hotchk155/latchbox-lite/hardware/latchbox-lite.brd

## EAGLE design hardware/latchbox-lite.brd (2019-11-06)

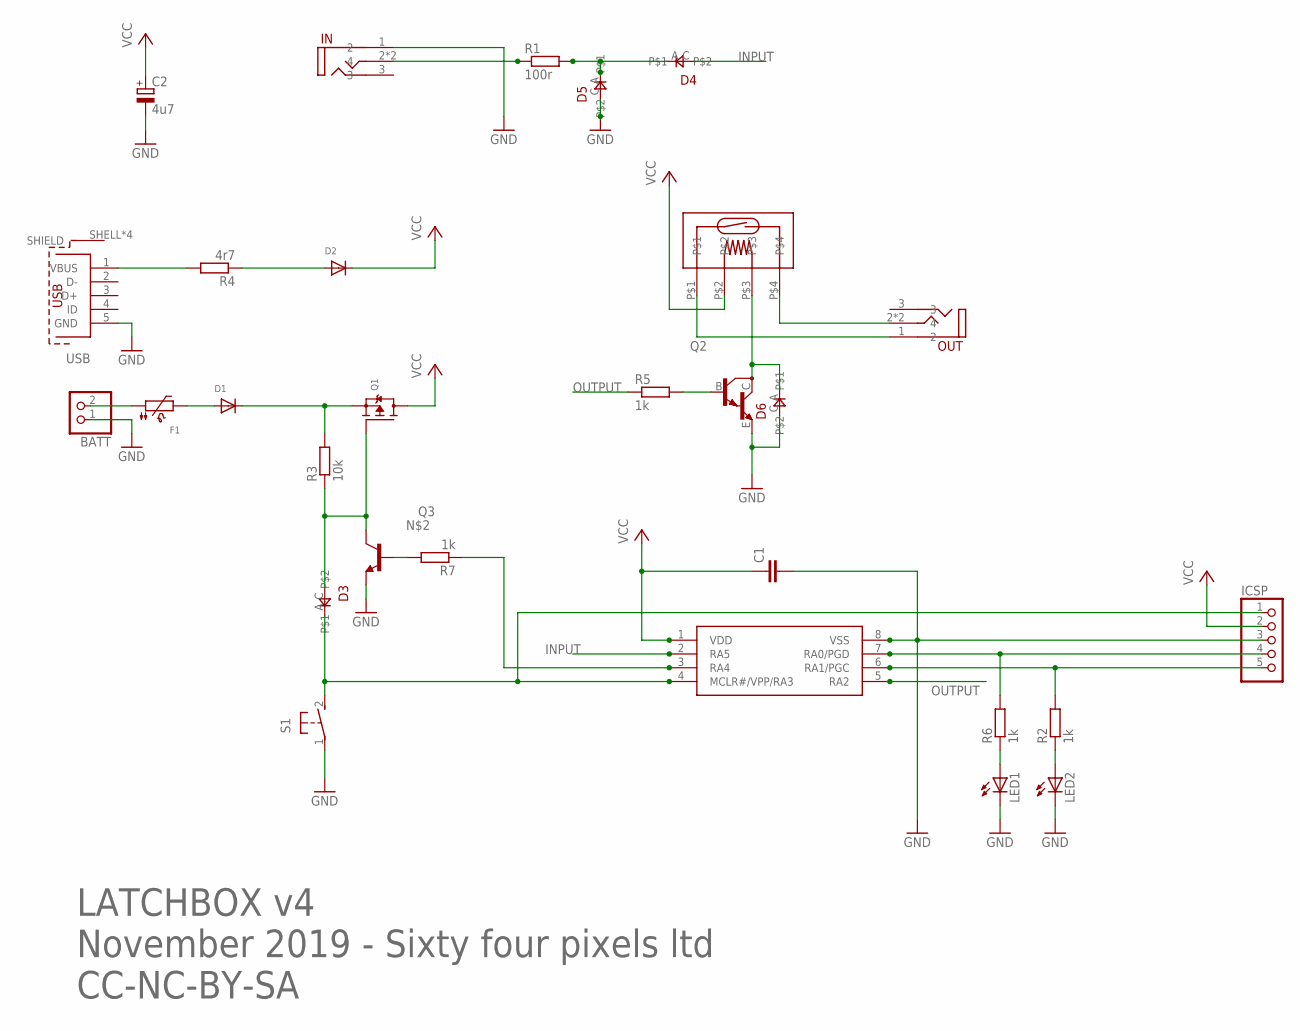
[picture p2: schematic latchbox-lite.sch]

Parts:
BATT: PINHD-1X2; 1X02
C1: C-EUC0805; C0805
C2: 4u7; E2,5-6E
D1, D2: DIODESOD-123; SOD-123
D3, D4, D5, D6: 0805DIODE
F1: PTC1206; 1206
IC1: PIC12F1822SO08; SO08
ICSP: PINHD-1X5; 1X05
IN: 3_5MM_PTH_MICRO
LED1, LED2: LED3MM
OUT: 3_5MM_PTH_MICRO
Q1: MOSFET-P; SOT23-R
Q2: MMBTA13LT1-NPN_DARL-SOT23-BEC; SOT23-BEC
Q3: MMBT3904LT1-NPN-SOT23-BEC; SOT23-BEC
R1: 100r; R0805
R2, R5, R6, R7: 1k; R0805
R3: 10k; R0805
R4: 4r7; R0805
RLY1: 9007-REED-RELAY
S1: 31-XX; B3F-31XX
USB: 629105150521

Connections:
GND: BATT.1, C1.2, C2.-, D5.C, D6.C, IC1.8 (VSS), ICSP.3, IN.1 (2), LED1.K (C), LED2.K (C), Q2.E, Q3.E, S1.1, USB.5 (GND)
INPUT: D4.C, IC1.2 (RA5)
unnamed: IN.2 (4), IN.2A (4), R1.1
unnamed: D3.C, Q1.1 (G), Q3.C, R3.1
unnamed: LED2.A, R2.1
unnamed: D1.C, Q1.2 (S), R3.2
unnamed: BATT.2, F1.1
unnamed: Q2.B, R5.2
unnamed: OUT.2 (4), OUT.2A (4), RLY1.P$4
unnamed: OUT.1 (2), RLY1.P$1
unnamed: D6.A, Q2.C, RLY1.P$3
unnamed: LED1.A, R6.1
unnamed: IC1.7 (RA0/PGD), ICSP.4, R6.2
unnamed: IC1.6 (RA1/PGC), ICSP.5, R2.2
unnamed: Q3.B, R7.2
unnamed: D3.A, IC1.4 (MCLR#/VPP/RA3), ICSP.1, S1.2 (S)
unnamed: D1.A, F1.2
unnamed: R4.2, USB.1 (VBUS)
OUTPUT: IC1.5 (RA2), R5.1
POWER_CTRL: IC1.3 (RA4), R7.1
USB_POWER: D2.A, R4.1
VCC: C1.1, C2.+, D2.C, IC1.1 (VDD), ICSP.2, Q1.3 (D), RLY1.P$2
Z: D4.A, D5.A, R1.2

Notes on the sheet:
LATCHBOX v4
November 2019 - Sixty four pixels ltd
CC-NC-BY-SA

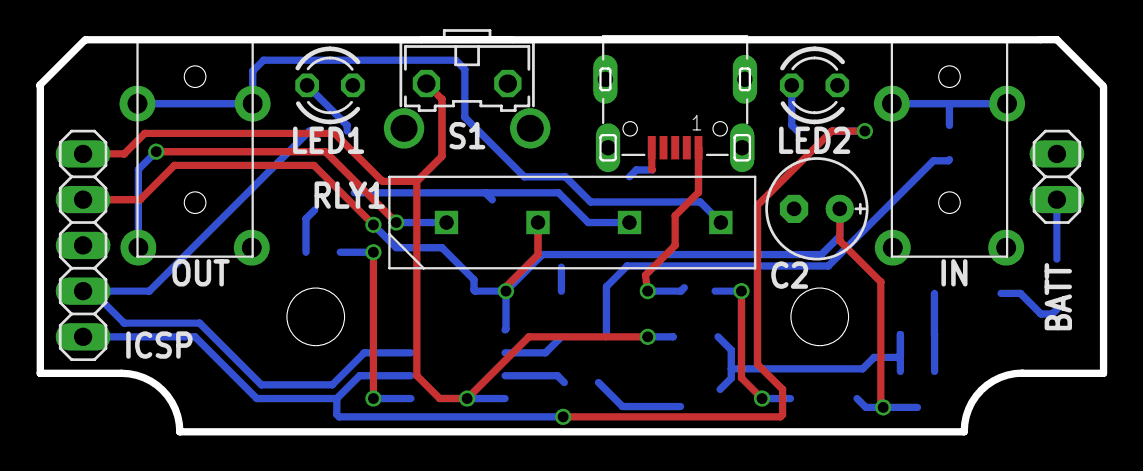
[picture p3: board latchbox-lite.brd from above]

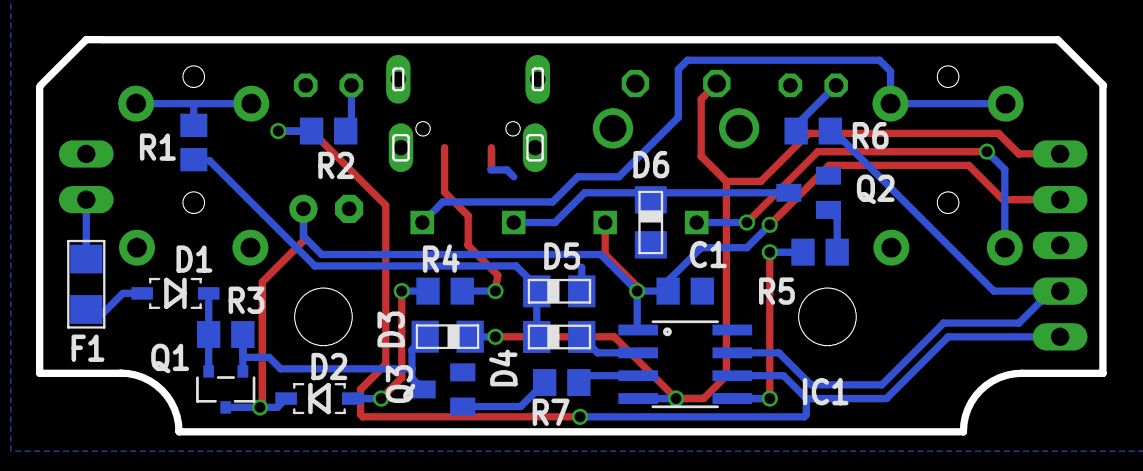
[picture p4: board latchbox-lite.brd from below]

Board: 2 copper layers, 59.1 x 21.8 mm, 29 parts (19 on the bottom side), 23 nets.
