hotchk155/latchbox-lite/pcb-panel/latchbox-lite-stencil.brd

## EAGLE design pcb-panel/latchbox-lite-stencil.brd (2019-12-02)

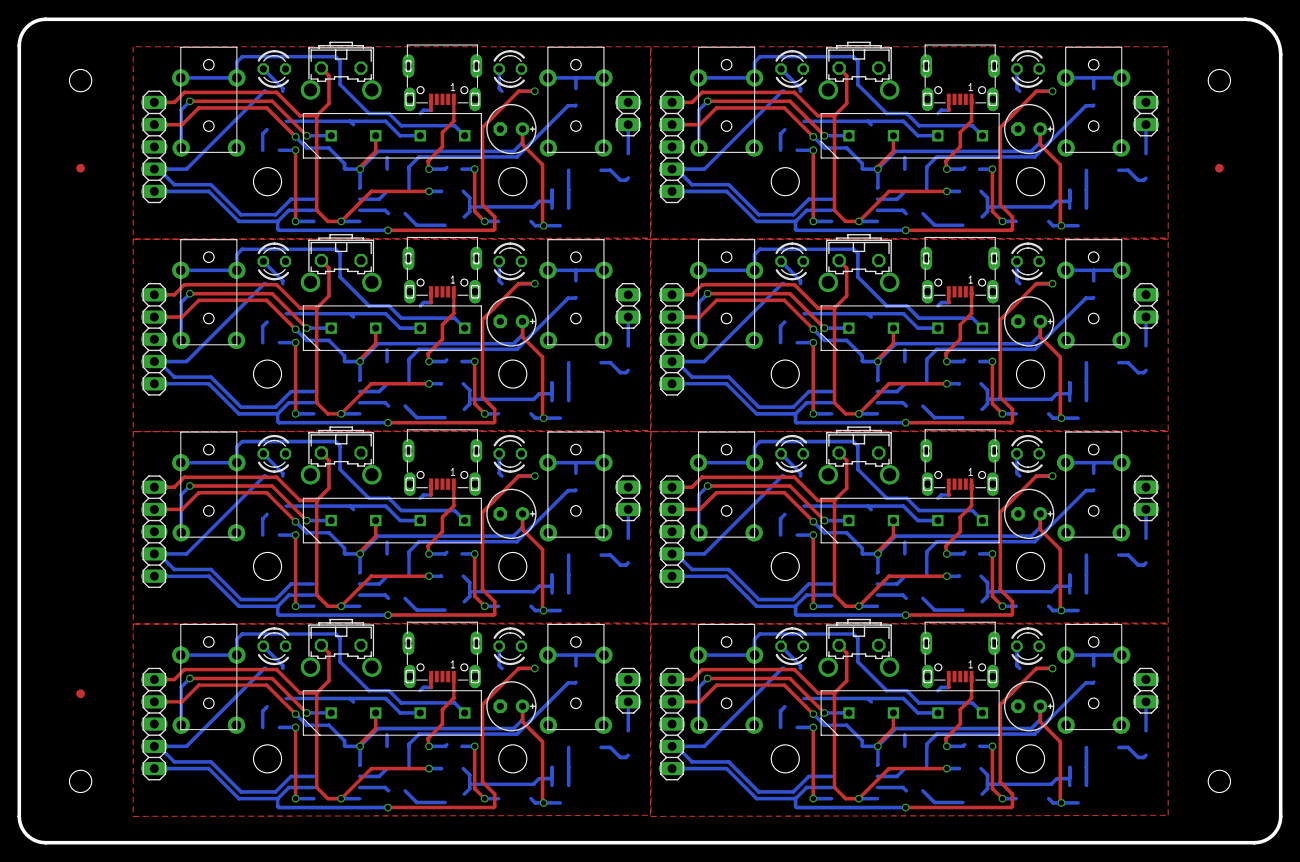
[picture p5: board latchbox-lite-stencil.brd from above]

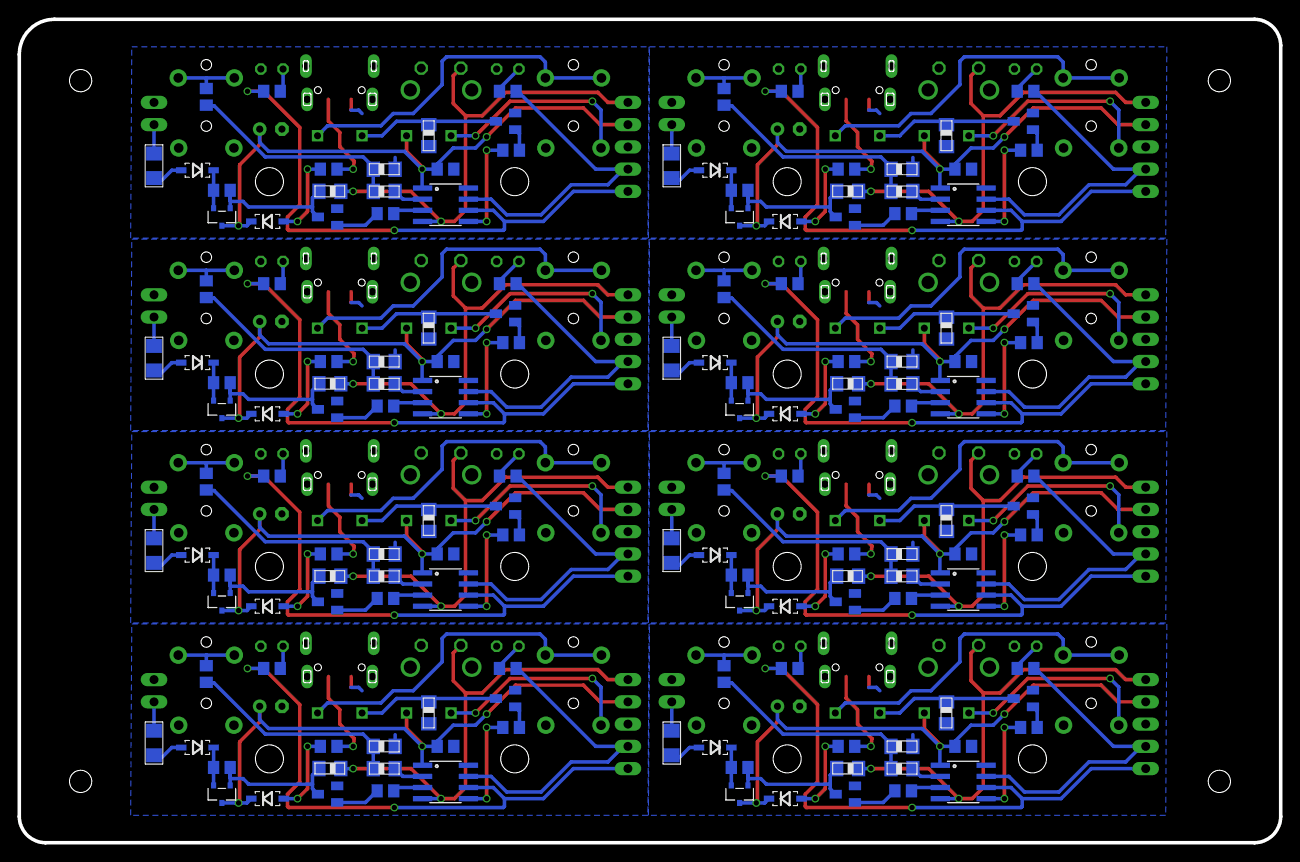
[picture p6: board latchbox-lite-stencil.brd from below]

Board: 2 copper layers, 144.0 x 94.0 mm, 235 parts (152 on the bottom side), 184 nets.

Parts:
BATT, BATT1, BATT2, BATT3, BATT4, BATT5, BATT6, BATT7: 1X02
C1, C3, C5, C7, C9, C11, C13, C15: C0805
C2, C4, C6, C8, C10, C12, C14, C16: 4u7; E2,5-6E
D1, D2, D9, D11, D15, D17, D21, D23, D27, D29, D33, D35, D39, D41, D45, D47: SOD-123
D3, D4, D5, D6, D7, D8, D10, D12, D13, D14, D16, D18, D19, D20, D22, D24, D25, D26, D28, D30, D31, D32, D34, D36, D37, D38, D40, D42, D43, D44, D46, D48: 0805DIODE
E$1, E$2, E$3: FIDUCIAL_1MM
F1, F2, F3, F4, F5, F6, F7, F8: 1206
IC1, IC2, IC3, IC4, IC5, IC6, IC7, IC8: PIC12F1822SO08; SO08
ICSP, ICSP1, ICSP2, ICSP3, ICSP4, ICSP5, ICSP6, ICSP7: 1X05
IN, IN1, IN2, IN3, IN4, IN5, IN6, IN7: 3_5MM_PTH_MICRO
LED1, LED2, LED3, LED4, LED5, LED6, LED7, LED8, LED9, LED10, LED11, LED12, LED13, LED14, LED15, LED16: LED3MM
OUT, OUT1, OUT2, OUT3, OUT4, OUT5, OUT6, OUT7: 3_5MM_PTH_MICRO
Q1, Q4, Q7, Q10, Q13, Q16, Q19, Q22: SOT23-R
Q2, Q3, Q5, Q6, Q8, Q9, Q11, Q12, Q14, Q15, Q17, Q18, Q20, Q21, Q23, Q24: SOT23-BEC
R1, R8, R15, R22, R29, R36, R43, R50: 100r; R0805
R2, R5, R6, R7, R9, R11, R12, R14, R16, R18, R19, R21, R23, R25, R26, R28, R30, R32, R33, R35, R37, R39, R40, R42, R44, R46, R47, R49, R51, R53, R54, R56: 1k; R0805
R3, R10, R17, R24, R31, R38, R45, R52: 10k; R0805
R4, R13, R20, R27, R34, R41, R48, R55: 4r7; R0805
RLY1, RLY2, RLY3, RLY4, RLY5, RLY6, RLY7, RLY8: 9007-REED-RELAY
S1, S2, S3, S4, S5, S6, S7, S8: B3F-31XX
USB, USB1, USB2, USB3, USB4, USB5, USB6, USB7: 629105150521

Connections:
GND: BATT.1, C1.2, C2.-, D5.C, D6.C, IC1.8, ICSP.3, IN.1, LED1.K, LED2.K, Q2.E, Q3.E, S1.1, USB.5
GND1: BATT1.1, C3.2, C4.-, D7.C, D8.C, IC2.8, ICSP1.3, IN1.1, LED3.K, LED4.K, Q5.E, Q6.E, S2.1, USB1.5
GND2: BATT2.1, C5.2, C6.-, D13.C, D14.C, IC3.8, ICSP2.3, IN2.1, LED5.K, LED6.K, Q8.E, Q9.E, S3.1, USB2.5
GND3: BATT3.1, C7.2, C8.-, D19.C, D20.C, IC4.8, ICSP3.3, IN3.1, LED7.K, LED8.K, Q11.E, Q12.E, S4.1, USB3.5
GND4: BATT4.1, C9.2, C10.-, D25.C, D26.C, IC5.8, ICSP4.3, IN4.1, LED9.K, LED10.K, Q14.E, Q15.E, S5.1, USB4.5
GND5: BATT5.1, C11.2, C12.-, D31.C, D32.C, IC6.8, ICSP5.3, IN5.1, LED11.K, LED12.K, Q17.E, Q18.E, S6.1, USB5.5
GND6: BATT6.1, C13.2, C14.-, D37.C, D38.C, IC7.8, ICSP6.3, IN6.1, LED13.K, LED14.K, Q20.E, Q21.E, S7.1, USB6.5
GND7: BATT7.1, C15.2, C16.-, D43.C, D44.C, IC8.8, ICSP7.3, IN7.1, LED15.K, LED16.K, Q23.E, Q24.E, S8.1, USB7.5
INPUT: D4.C, IC1.2
INPUT1: D10.C, IC2.2
INPUT2: D16.C, IC3.2
INPUT3: D22.C, IC4.2
INPUT4: D28.C, IC5.2
INPUT5: D34.C, IC6.2
INPUT6: D40.C, IC7.2
INPUT7: D46.C, IC8.2
unnamed: IN.2, IN.2A, R1.1
unnamed: D3.C, Q1.1, Q3.C, R3.1
unnamed: LED2.A, R2.1
unnamed: D1.C, Q1.2, R3.2
unnamed: BATT.2, F1.1
unnamed: Q2.B, R5.2
unnamed: OUT.2, OUT.2A, RLY1.P$4
unnamed: OUT.1, RLY1.P$1
unnamed: D6.A, Q2.C, RLY1.P$3
unnamed: LED1.A, R6.1
unnamed: IC1.7, ICSP.4, R6.2
unnamed: IC1.6, ICSP.5, R2.2
unnamed: Q3.B, R7.2
unnamed: D3.A, IC1.4, ICSP.1, S1.2
unnamed: D1.A, F1.2
unnamed: R4.2, USB.1
unnamed: IN1.2, IN1.2A, R8.1
unnamed: D9.C, Q4.2, R10.2
unnamed: BATT1.2, F2.1
unnamed: OUT1.2, OUT1.2A, RLY2.P$4
unnamed: OUT1.1, RLY2.P$1
unnamed: D8.A, Q5.C, RLY2.P$3
unnamed: D12.A, IC2.4, ICSP1.1, S2.2
unnamed: IC2.7, ICSP1.4, R11.2
unnamed: IC2.6, ICSP1.5, R12.2
unnamed: LED3.A, R12.1
unnamed: Q5.B, R9.2
unnamed: D9.A, F2.2
unnamed: R13.2, USB1.1
unnamed: LED4.A, R11.1
unnamed: D12.C, Q4.1, Q6.C, R10.1
unnamed: Q6.B, R14.2
unnamed: IN2.2, IN2.2A, R15.1
unnamed: D15.C, Q7.2, R17.2
unnamed: BATT2.2, F3.1
unnamed: OUT2.2, OUT2.2A, RLY3.P$4
unnamed: OUT2.1, RLY3.P$1
unnamed: D14.A, Q8.C, RLY3.P$3
unnamed: D18.A, IC3.4, ICSP2.1, S3.2
unnamed: IC3.7, ICSP2.4, R18.2
unnamed: IC3.6, ICSP2.5, R19.2
unnamed: LED5.A, R19.1
unnamed: Q8.B, R16.2
unnamed: D15.A, F3.2
unnamed: R20.2, USB2.1
unnamed: LED6.A, R18.1
unnamed: D18.C, Q7.1, Q9.C, R17.1
unnamed: Q9.B, R21.2
unnamed: IN3.2, IN3.2A, R22.1
unnamed: D21.C, Q10.2, R24.2
unnamed: BATT3.2, F4.1
unnamed: OUT3.2, OUT3.2A, RLY4.P$4
unnamed: OUT3.1, RLY4.P$1
unnamed: D20.A, Q11.C, RLY4.P$3
unnamed: D24.A, IC4.4, ICSP3.1, S4.2
unnamed: IC4.7, ICSP3.4, R25.2
unnamed: IC4.6, ICSP3.5, R26.2
unnamed: LED7.A, R26.1
unnamed: Q11.B, R23.2
unnamed: D21.A, F4.2
unnamed: R27.2, USB3.1
unnamed: LED8.A, R25.1
unnamed: D24.C, Q10.1, Q12.C, R24.1
unnamed: Q12.B, R28.2
unnamed: IN4.2, IN4.2A, R29.1
unnamed: D27.C, Q13.2, R31.2
unnamed: BATT4.2, F5.1
unnamed: OUT4.2, OUT4.2A, RLY5.P$4
unnamed: OUT4.1, RLY5.P$1
unnamed: D26.A, Q14.C, RLY5.P$3
unnamed: D30.A, IC5.4, ICSP4.1, S5.2
unnamed: IC5.7, ICSP4.4, R32.2
unnamed: IC5.6, ICSP4.5, R33.2
unnamed: LED9.A, R33.1
unnamed: Q14.B, R30.2
unnamed: D27.A, F5.2
unnamed: R34.2, USB4.1
unnamed: LED10.A, R32.1
unnamed: D30.C, Q13.1, Q15.C, R31.1
unnamed: Q15.B, R35.2
unnamed: IN5.2, IN5.2A, R36.1
unnamed: D33.C, Q16.2, R38.2
unnamed: BATT5.2, F6.1
unnamed: OUT5.2, OUT5.2A, RLY6.P$4
unnamed: OUT5.1, RLY6.P$1
unnamed: D32.A, Q17.C, RLY6.P$3
unnamed: D36.A, IC6.4, ICSP5.1, S6.2
unnamed: IC6.7, ICSP5.4, R39.2
unnamed: IC6.6, ICSP5.5, R40.2
unnamed: LED11.A, R40.1
unnamed: Q17.B, R37.2
unnamed: D33.A, F6.2
unnamed: R41.2, USB5.1
unnamed: LED12.A, R39.1
unnamed: D36.C, Q16.1, Q18.C, R38.1
unnamed: Q18.B, R42.2
unnamed: IN6.2, IN6.2A, R43.1
unnamed: D39.C, Q19.2, R45.2
unnamed: BATT6.2, F7.1
unnamed: OUT6.2, OUT6.2A, RLY7.P$4
unnamed: OUT6.1, RLY7.P$1
unnamed: D38.A, Q20.C, RLY7.P$3
unnamed: D42.A, IC7.4, ICSP6.1, S7.2
unnamed: IC7.7, ICSP6.4, R46.2
unnamed: IC7.6, ICSP6.5, R47.2
unnamed: LED13.A, R47.1
unnamed: Q20.B, R44.2
unnamed: D39.A, F7.2
unnamed: R48.2, USB6.1
unnamed: LED14.A, R46.1
unnamed: D42.C, Q19.1, Q21.C, R45.1
unnamed: Q21.B, R49.2
unnamed: IN7.2, IN7.2A, R50.1
unnamed: D45.C, Q22.2, R52.2
unnamed: BATT7.2, F8.1
unnamed: OUT7.2, OUT7.2A, RLY8.P$4
unnamed: OUT7.1, RLY8.P$1
unnamed: D44.A, Q23.C, RLY8.P$3
unnamed: D48.A, IC8.4, ICSP7.1, S8.2
unnamed: IC8.7, ICSP7.4, R53.2
unnamed: IC8.6, ICSP7.5, R54.2
unnamed: LED15.A, R54.1
unnamed: Q23.B, R51.2
unnamed: D45.A, F8.2
unnamed: R55.2, USB7.1
unnamed: LED16.A, R53.1
unnamed: D48.C, Q22.1, Q24.C, R52.1
unnamed: Q24.B, R56.2
OUTPUT: IC1.5, R5.1
OUTPUT1: IC2.5, R9.1
OUTPUT2: IC3.5, R16.1
OUTPUT3: IC4.5, R23.1
OUTPUT4: IC5.5, R30.1
OUTPUT5: IC6.5, R37.1
OUTPUT6: IC7.5, R44.1
OUTPUT7: IC8.5, R51.1
POWER_CTRL: IC1.3, R7.1
POWER_CTRL1: IC2.3, R14.1
POWER_CTRL2: IC3.3, R21.1
POWER_CTRL3: IC4.3, R28.1
POWER_CTRL4: IC5.3, R35.1
POWER_CTRL5: IC6.3, R42.1
POWER_CTRL6: IC7.3, R49.1
POWER_CTRL7: IC8.3, R56.1
USB_POWER: D2.A, R4.1
USB_POWER1: D11.A, R13.1
USB_POWER2: D17.A, R20.1
USB_POWER3: D23.A, R27.1
USB_POWER4: D29.A, R34.1
USB_POWER5: D35.A, R41.1
USB_POWER6: D41.A, R48.1
USB_POWER7: D47.A, R55.1
VCC: C1.1, C2.+, D2.C, IC1.1, ICSP.2, Q1.3, RLY1.P$2
VCC1: C3.1, C4.+, D11.C, IC2.1, ICSP1.2, Q4.3, RLY2.P$2
VCC2: C5.1, C6.+, D17.C, IC3.1, ICSP2.2, Q7.3, RLY3.P$2
VCC3: C7.1, C8.+, D23.C, IC4.1, ICSP3.2, Q10.3, RLY4.P$2
VCC4: C9.1, C10.+, D29.C, IC5.1, ICSP4.2, Q13.3, RLY5.P$2
VCC5: C11.1, C12.+, D35.C, IC6.1, ICSP5.2, Q16.3, RLY6.P$2
VCC6: C13.1, C14.+, D41.C, IC7.1, ICSP6.2, Q19.3, RLY7.P$2
VCC7: C15.1, C16.+, D47.C, IC8.1, ICSP7.2, Q22.3, RLY8.P$2
Z: D4.A, D5.A, R1.2
Z1: D7.A, D10.A, R8.2
Z2: D13.A, D16.A, R15.2
Z3: D19.A, D22.A, R22.2
Z4: D25.A, D28.A, R29.2
Z5: D31.A, D34.A, R36.2
Z6: D37.A, D40.A, R43.2
Z7: D43.A, D46.A, R50.2
