hotchk155/latchbox-lite/(commit log)

2019-07-01 version 1 proto
    [latchbox-lite.brd, latchbox-lite.sch]
2019-07-24 prototype code
2019-08-17 v2 possible
    [latchbox-lite.brd, latchbox-lite.sch]
2019-10-08 V3 BOARD
    [latchbox-lite.brd, latchbox-lite.sch]
2019-10-25 V2 firmware
    [latchbox-lite.brd, latchbox-lite.sch]
2019-11-06 move about
    [latchbox-lite.brd, latchbox-lite.sch]
2019-11-06 V4 PANEL
    [latchbox-lite.brd]
2019-12-02 bom etc
    [BOM.xlsx]
